Juani005999/ROMV2-SQMLite/README.md

# ROMV2 / SQM Lite

ROM V2 et SQM Lite

## Sommaire
- [Description](#description)
    - [Fonctionnalités](#fonctionnalités)
    - [Modèles](#modèles)
        - [Fonctionnalités par modèle](#fonctionnalités-par-modèle)
        - [Écrans disponibles](#écrans-disponibles)
    - [Echelle de Bortle](#echelle-de-bortle)
- [Liste des pièces](#liste-des-pièces)
    - [Liste des pièces du ROMV2](#liste-des-pièces-du-romv2)
        - [Amazon](#amazon)
        - [Ali Express](#ali-express)
        - [Visserie & Divers](#visserie--divers)
    - [Liste des pièces du SQMLite](#liste-des-pièces-du-sqmlite)
        - [Amazon](#amazon-1)
        - [Ali Express](#ali-express-1)
        - [Visserie & Divers](#visserie--divers-1)
- [Montage](#montage)
    - [Montage du ROMV2](#montage-du-romv2)
        - [Breadboard](#breadboard)
        - [PCB](#pcb)
        - [ESP32](#esp32)
        - [Capteurs](#capteurs)
    - [Montage du SQMLite](#montage-du-sqmlite)
        - [Breadboard](#breadboard-1)
        - [PCB](#pcb-1)
        - [ESP32](#esp32-1)
        - [Capteurs](#capteurs-1)
    - [Boxes](#boxes)
    - [Optique du TSL2591](#optique-du-tsl2591)
- [Firmware](#firmware)
    - [Bibliothèques nécessaires à l'application](#bibliothèques-nécessaires-à-lapplication)
    - [Sélection de la carte](#sélection-de-la-carte)
    - [Paramètres de l'application dans Arduino IDE](#paramètres-de-lapplication-dans-arduino-ide)
    - [Configuration de l'application](#configuration-de-lapplication)
    - [Configuration de l'écran TFT ST7735](#configuration-de-lécran-tft-st7735)
    - [Implémentation](#implémentation)
    - [Mode \"Debug\"](#mode-debug)
- [Utilisation](#utilisation)
    - [Matériel (ROMV2)](#matériel-romv2)
    - [Matériel (SQMLite)](#matériel-sqmlite)
    - [Navigation](#navigation)
    - [Mise en veille](#mise-en-veille)
    - [Logiciel](#logiciel)
        - [En-tête (ROMV2)](#en-tête-romv2)
        - [En-tête (SQMLite)](#en-tête-sqmlite)
        - [Ecran d'accueil](#ecran-daccueil)
        - [Ecran Luminosité](#ecran-luminosité)
        - [Ecran Environnement](#ecran-environnement)
        - [Ecran Ir Température](#ecran-ir-température)
        - [Ecran Niveaux](#ecran-niveaux)
        - [Ecran GPS](#ecran-gps)
        - [Ecran de calibration du capteur de luminosité TSL2591](#ecran-de-calibration-du-capteur-de-luminosité-tsl2591)
- [Driver ASCOM](#driver-ascom)
    - [Installation](#installation)
    - [Détection du périphérique bluetooth dans Windows](#détection-du-périphérique-bluetooth-dans-windows)
    - [Utilisation dans NINA](#utilisation-dans-nina)
        - [Sélection du ROM V2 dans NINA](#sélection-du-rom-v2-dans-nina)
        - [Première utilisation dans NINA](#première-utilisation-dans-nina)
- [Visualisation des données dans Grafana](#visualisation-des-données-dans-grafana)
    - [Mosquitto](#mosquitto)
    - [InfluxDB 2.x](#influxdb-2x)
    - [Telegraf](#telegraf)
    - [Grafana](#grafana)
    - [Résultat](#résultat)
- [Retex](#retex)
- [Révisions](#révisions)

## Description
Le **ROMV2** est un Sky Quality Meter (SQM) DIY (Do It Yourself) contenant les composants suivants :
- TSL2591
- MLX90614
- BME280
- ADXL345
- GPS NEO 8M
- TFT ST7735

Le **SQMLite** est un Sky Quality Meter (SQM) DIY (Do It Yourself) contenant les composants suivants :
- TSL2591
- BME280
- TFT ST7735

Le **SQMLite** est une version à moindre coût, centrée sur la mesure de qualité du ciel (SQM / Bortle) et des conditions d'environnement, sans la partie état du ciel, niveau à bulle ni GPS.

<p align="right"><a href="#sommaire">Retour au sommaire</a></p>

### Fonctionnalités

- Lecture de la luminosité (full / ir / visible), calcul de la quantité de lux, du SQM et du Bortle.
- Lecture de la luminosité dans une tâche dédiée FreeRTOS s'exécutant en parallèle sur le 2ème coeur de l'ESP 32.
- Correction thermique de la lecture de la luminosité avec la température ambiante.
- Moyenne mobile du lux sur 50 valeurs permettant de réduire l'incertitude mesurée. Calcul du SQM et du Bortle sur la moyenne mobile du lux.
- Possibilité de remise à zéro de la moyenne mobile.
- Réglage automatique de la sensibilité (1x, 25x, 428x, 9876x) et de la durée de mesure (100ms, 200ms, 300ms, 400ms, 500ms, 600ms) du capteur de luminosité TSL2591.
- (*) Lecture de la qualité du ciel (3 états : ciel clair / peu nuageux / nuageux) via le capteur MLX90614 permettant la lecture de la température du ciel.
- Lecture des conditions d'environnement (Température, taux d'humidité, pression atmosphérique) via le capteur BME280.
- Calcul du point de rosée.
- (*) Niveaux à bulle permettant de diriger l'optique vers le zénith grâce au capteur ADXL345.
- (*) Coordonnées GPS et Date/Heure UTC issues du capteur GPS NEO 8M.
- Connection Bluetooth BLE.
- Driver ASCOM permettant de se connecter via Bluetooth BLE.
- Connection Wifi et Broker MQTT.
- Indicateur de mesure de luminosité en cours.
- Indicateur d'état de connection Bluetooth BLE client / Wifi MQTT / Offline.
- (*) Indicateur d'état du GPS.
- Indicateur de charge restante dans la batterie.
- Mise en veille de l'écran après 5 minutes d'inactivité ou sur demande.
- Ecran de calibration du capteur de luminosité (TSL2591) avec sauvegarde et lecture de la calibration en EEPROM permettant de stocker cette valeur même après extinction de l'appareil.
- Ecran de sélection de la connection réseau : Bluetooth BLE / Wifi MQTT / Offline. Sauvegarde du paramètre en EEPROM.
- Ecran de paramétrage de la connection Wifi et Broker MQTT. Page web se connectant au périphérique et permettant la saisie des paramètres réseaux. Sauvegarde des paramètres réseaux en EEPROM.

(*) ***ROMV2*** uniquement

<p align="right"><a href="#sommaire">Retour au sommaire</a></p>

### Modèles

#### Fonctionnalités par modèle
| Composant / Fonction | ROMV2 | SQMLite |
| --- | :---: | :---: |
| TSL2591 — Luminosité / SQM / Bortle | ✅ | ✅ |
| BME280 — Environnement / point de rosée | ✅ | ✅ |
| TFT ST7735 — Affichage | ✅ | ✅ |
| MLX90614 — État du ciel (IR) | ✅ | ❌ |
| ADXL345 — Niveau à bulle | ✅ | ❌ |
| GPS NEO 8M — Coordonnées / UTC | ✅ | ❌ |
| Connexion BLE + Driver ASCOM | ✅ | ✅ |
| WiFi / MQTT | ✅ | ✅ |

#### Écrans disponibles
| Écran | ROMV2 | SQMLite |
| --- | :---: | :---: |
| Accueil | ✅ | ✅ |
| Luminosité | ✅ | ✅ |
| Environnement | ✅ | ✅ |
| Ir Température | ✅ | ❌ |
| Niveaux | ✅ | ❌ |
| GPS | ✅ | ❌ |
| Sélection de la connection réseau | ✅ | ✅ |
| Paramétrage du Wifi MQTT | ✅ | ✅ |
| Calibration du capteur de luminosité TSL 2591 | ✅ | ✅ |

> [!TIP]
> Le choix du modèle se fait simplement en ouvrant le bon exemple dans l'Arduino IDE (***Fichier*** -> ***Exemples*** -> ***ROMV2*** -> ***ROMV2*** ou ***SQMLite***). La même bibliothèque et la même configuration `ROMV2_APP_CONFIG.h` servent les deux.

<p align="right"><a href="#sommaire">Retour au sommaire</a></p>

### Echelle de Bortle

Voici l'échelle de Bortle utilisée dans l'application.

Bortle Scale

<p align="right"><a href="#sommaire">Retour au sommaire</a></p>

## Liste des pièces
### Liste des pièces du ROMV2
#### Amazon

| Composant | Prix | Nb. pièces | Prix unitaire |
| --- | --- | --- | --- |
| [ESP32 with Battery (Micro USB)](https://www.amazon.fr/dp/B07YXFBFWF) | 18.77 € | 1 | 18.77 € |
| [TSL2591](https://www.amazon.fr/dp/B0GGD3FNKM) | 15.10 € | 1 | 15.10 € |
| [BME280](https://www.amazon.fr/dp/B07HMQMW6M) | 30.99 € | 5 | 6.20 € |
| [ADXL345](https://www.amazon.fr/ADXL345-Acc%C3%A9l%C3%A9rom%C3%A8tres-Acc%C3%A9l%C3%A9rom%C3%A8tre-Num%C3%A9rique-Transmission/dp/B0CMHXKVFK) | 10.56 € | 5 | 2.12 € |
| [MLX90614](https://www.amazon.fr/Fyearfly-Capteur-Temp%C3%A9rature-Infrarouge-MLX90614ESF/dp/B0CG9VL65J) | 33.49 € | 2 | 16.75 € |
| [GPS NEO 8M](https://www.amazon.fr/ElectroWorldFR-Module-NEO-8M-antenne-c%C3%A9ramique/dp/B09TX372XH) | 20.99 € | 1 | 20.99 € |
| [TFT ST7735](https://www.amazon.fr/AZDelivery-TFT-Compatible-Raspberry-incluant/dp/B07TJGF8HS) | 27.99 € | 5 | 5.60 € |
| [Lentille D23 F30](https://www.amazon.fr/Lentille-biconvexe-Double-Convexe-Optique/dp/B0GVHDZD22) | 25.94 € | 1 | 25.94 € |
| [Joystick](https://www.amazon.fr/Gebildet-Joystick-Commande-Contr%C3%B4leur-Raspberry/dp/B0DPMN19G6) | 10.99 € | 8 | 1.37 € |
| [Boot Button](https://www.amazon.fr/dp/B07S1MNB8C) | 10.99 € | 5 | 2.20 € |
| [Interrupteur à bascule](https://www.amazon.fr/dp/B076VKRKQQ) | 6.49 € | 5 | 1.30 € |
| [Rallonge Micro USB](https://www.amazon.fr/dp/B08HCTZ9P5) | 11.79 € | 2 | 5.90 € |
| [Testeur de capacité](https://www.amazon.fr/dp/B0DKHT664R) | 13.19 € | 4 | 3.30 € |
| | | Total | **125.54 €** |

<p align="right"><a href="#sommaire">Retour au sommaire</a></p>

#### Ali Express
| Composant | Prix | Nb. pièces | Prix unitaire |
| --- | --- | --- | --- |
| [ESP32 with Battery (Micro USB)](https://fr.aliexpress.com/item/1005007579177706.html) | 4.19 € | 1 | 4.19 € |
| [TSL2591](https://fr.aliexpress.com/item/1005009222536594.html) | 4.19 € | 1 | 4.19 € |
| [BME280](https://fr.aliexpress.com/item/1005010256393146.html) | 2.99 € | 1 | 2.99 € |
| [ADXL345](https://fr.aliexpress.com/item/1005007076396937.html) | 2.04 € | 1 | 2.04 € |
| [MLX90614](https://fr.aliexpress.com/item/32853499710.html) | 5.93 € | 1 | 5.93 € |
| [GPS NEO 8M](https://fr.aliexpress.com/item/1005006323393609.html) | 9.29 € | 1 | 9.29 € |
| [TFT ST7735](https://fr.aliexpress.com/item/1005008974306385.html) | 3.20 € | 1 | 3.20 € |
| [Lentille D23 F30](https://fr.aliexpress.com/item/1005007033633969.html) | 2.06 € | 1 | 2.06 € |
| [Joystick](https://fr.aliexpress.com/item/1005009009852719.html) | 0.51 € | 1 | 0.51 € |
| [Boot Button](https://fr.aliexpress.com/item/1005007876916629.html) | 6.69 € | 5 | 1.34 € |
| [Interrupteur à bascule](https://fr.aliexpress.com/item/1005010311259797.html) | 1.65 € | 10 | 0.17 € |
| [Rallonge Micro USB](https://fr.aliexpress.com/item/1005005292730047.html) | 1.09 € | 1 | 1.09 € |
| [Testeur de capacité](https://fr.aliexpress.com/item/1005006350742151.html) | 1.45 € | 1 | 1.45 € |
| | | Total | **38.45 €** |

<p align="right"><a href="#sommaire">Retour au sommaire</a></p>

#### Visserie & Divers

| Composant | Propriétés | Quantité |
| --- | --- | --- |
| Vis & rondelles | M4 x 20mm | 8 |
| Vis & rondelles | M2 x 20mm | 4 |
| Vis & rondelles | M2 x 8mm | 21 |
| Vis & rondelles | M2 x 6mm | 8 |
| Ecrou Nylstop autobloquants | M2 | 7 |
| Condensateur | 100 µF | 1 |
| Condensateur céramique | 100 nF | 1 |
| [PCB EPLZON](https://www.amazon.fr/dp/B0B5DCHM7K) | ... | 1 |
| [Câbles Dupont](https://www.amazon.fr/Breadboard-Jumper-Wires-Dupont-Cable/dp/B0BTT48V7P) | ... | ... |
| [PCB Vis Connecteur](https://www.amazon.fr/dp/B082ZNRQMJ?th=1) | ... | ... |
| [Jumper Breadboard](https://www.amazon.fr/dp/B0F6LJS4L2?ref=ppx_yo2ov_dt_b_fed_asin_title) | ... | ... |
| [Pile Rechargeable 18650](https://bestpiles.fr/piles-rechargeables-18650/991-pile-rechargeable-18650-inr18650mj1-li-ion-37v-3500mah-10a-8438493099829.html) | Li-ion 3,7V 3500mAh 10A | 1 |

<p align="right"><a href="#sommaire">Retour au sommaire</a></p>

### Liste des pièces du SQMLite
#### Amazon

| Composant | Prix | Nb. pièces | Prix unitaire |
| --- | --- | --- | --- |
| ESP32 with Battery (USB-C) | 18.77 € | 1 | 18.77 € |
| [TSL2591](https://www.amazon.fr/dp/B0GGD3FNKM) | 12.69 € | 1 | 12.69 € |
| [BME280](https://www.amazon.fr/dp/B07HMQMW6M) | 39.48 € | 5 | 7.90 € |
| [TFT ST7735](https://www.amazon.fr/AZDelivery-TFT-Compatible-Raspberry-incluant/dp/B07TJGF8HS) | 27.99 € | 5 | 5.60 € |
| [Lentille D23 F30](https://www.amazon.fr/Lentille-biconvexe-Double-Convexe-Optique/dp/B0GVHDZD22) | 25.94 € | 1 | 25.94 € |
| [Joystick](https://www.amazon.fr/Gebildet-Joystick-Commande-Contr%C3%B4leur-Raspberry/dp/B0DPMN19G6) | 10.99 € | 8 | 1.37 € |
| [Boot Button](https://www.amazon.fr/dp/B07S1MNB8C) | 10.99 € | 5 | 2.20 € |
| [Interrupteur à bascule](https://www.amazon.fr/dp/B076VKRKQQ) | 7.49 € | 5 | 1.50 € |
| [Rallonge USB-C](https://www.amazon.fr/Cablecc-3-1-type-femelle-donn%C3%A9es-dextension/dp/B075P2FF7L) | 17.56 € | 1 | 17.56 € |
| [Testeur de capacité](https://www.amazon.fr/dp/B0DKHT664R) | 12.79 € | 4 | 3.20 € |
| | | Total | **96.73 €** |

<p align="right"><a href="#sommaire">Retour au sommaire</a></p>

#### Ali Express
| Composant | Prix | Nb. pièces | Prix unitaire |
| --- | --- | --- | --- |
| [ESP32 with Battery (USB-C)](https://fr.aliexpress.com/item/1005007579177706.html) | 5.09 € | 1 | 5.09 € |
| [TSL2591](https://fr.aliexpress.com/item/1005009222536594.html) | 3.79 € | 1 | 3.79 € |
| [BME280](https://fr.aliexpress.com/item/1005010256393146.html) | 4.59 € | 1 | 4.59 € |
| [TFT ST7735](https://fr.aliexpress.com/item/1005008974306385.html) | 3.29 € | 1 | 3.29 € |
| [Lentille D23 F30](https://fr.aliexpress.com/item/1005007033633969.html) | 2.33 € | 1 | 2.33 € |
| [Joystick](https://fr.aliexpress.com/item/1005009009852719.html) | 0.46 € | 1 | 0.46 € |
| [Boot Button](https://fr.aliexpress.com/item/1005007876916629.html) | 26.19 € | 20 | 1.31 € |
| [Interrupteur à bascule](https://fr.aliexpress.com/item/1005010311259797.html) | 1.79 € | 10 | 0.18 € |
| [Rallonge USB-C 0.2m](https://fr.aliexpress.com/item/1005005292730047.html) | 1.71 € | 1 | 1.71 € |
| [Testeur de capacité](https://fr.aliexpress.com/item/1005006350742151.html) | 1.45 € | 1 | 1.45 € |
| | | Total | **24.20 €** |

<p align="right"><a href="#sommaire">Retour au sommaire</a></p>

#### Visserie & Divers
| Composant | Propriétés | Quantité |
| --- | --- | --- |
| Vis & rondelles | M4 x 20mm | 8 |
| Vis & rondelles | M2 x 20mm | 4 |
| Vis & rondelles | M2 x 8mm | 21 |
| Vis & rondelles | M2 x 6mm | 8 |
| Ecrou Nylstop autobloquants | M2 | 7 |
| [PCB EPLZON](https://www.amazon.fr/dp/B0B5DCHM7K) | ... | 1 |
| [Câbles Dupont](https://www.amazon.fr/Breadboard-Jumper-Wires-Dupont-Cable/dp/B0BTT48V7P) | ... | ... |
| [PCB Vis Connecteur](https://www.amazon.fr/dp/B082ZNRQMJ?th=1) | ... | ... |
| [Jumper Breadboard](https://www.amazon.fr/dp/B0F6LJS4L2?ref=ppx_yo2ov_dt_b_fed_asin_title) | ... | ... |
| [Pile Rechargeable 18650](https://bestpiles.fr/piles-rechargeables-18650/991-pile-rechargeable-18650-inr18650mj1-li-ion-37v-3500mah-10a-8438493099829.html) | Li-ion 3,7V 3500mAh 10A | 1 |

<p align="right"><a href="#sommaire">Retour au sommaire</a></p>

## Montage

### Montage du ROMV2

Montage
Montage

<p align="right"><a href="#sommaire">Retour au sommaire</a></p>

#### Breadboard
Breadboard

<p align="right"><a href="#sommaire">Retour au sommaire</a></p>

#### PCB
PCB
PCB

<p align="right"><a href="#sommaire">Retour au sommaire</a></p>

#### ESP32
Des branchements direct sur l'ESP32 sont nécessaires :
- 2 câbles Dupont branchés directement sur l'interrupteur de l'ESP et connectés à l'interrupteur du ROM.
- 2 câbles branchés sur les pôles + et - de l'ESP et connectés à l'indicateur de charge restante de la batterie.

ESP32

> [!WARNING]
> Attention, le connecteur **micro USB** présent sur l'ESP est **très très fragile** (j'en ai personnellement cassé plusieurs sur d'autres projets en faisant des branchements). Je vous conseille donc de rajouter 2 points de soudure de part et d'autre du connecteur  afin d'augmenter sa solidité.

<p align="right"><a href="#sommaire">Retour au sommaire</a></p>

#### Capteurs
Capteurs
Capteurs

<p align="right"><a href="#sommaire">Retour au sommaire</a></p>

### Montage du SQMLite
Montage

<p align="right"><a href="#sommaire">Retour au sommaire</a></p>

#### Breadboard
Breadboard

<p align="right"><a href="#sommaire">Retour au sommaire</a></p>

#### PCB
PCB
PCB

<p align="right"><a href="#sommaire">Retour au sommaire</a></p>

#### ESP32
Des branchements direct sur l'ESP32 sont nécessaires :
- 2 câbles Dupont branchés directement sur l'interrupteur de l'ESP et connectés à l'interrupteur du **SQM Lite**.
- 2 câbles branchés sur les pôles + et - de l'ESP et connectés à l'indicateur de charge restante de la batterie.

ESP32

> [!WARNING]
> Attention, le connecteur **USB-C** présent sur l'ESP est **très très fragile** (j'en ai personnellement cassé plusieurs sur d'autres projets en faisant des branchements). Je vous conseille donc de rajouter 2 points de soudure de part et d'autre du connecteur  afin d'augmenter sa solidité.

<p align="right"><a href="#sommaire">Retour au sommaire</a></p>

#### Capteurs
Capteurs
Capteurs
Capteurs
Capteurs

<p align="right"><a href="#sommaire">Retour au sommaire</a></p>

### Boxes
Vous trouverez dans [ce dossier](./Boxes/) tous les fichiers STL nécessaires à l'impression 3D.

<p align="right"><a href="#sommaire">Retour au sommaire</a></p>

### Optique du TSL2591
TSL2591
TSL2591
TSL2591

> [!IMPORTANT]
> La partie encadrée en jaune correspond au côté des vis du TSL2591.

> [!TIP]
> La lentille est optionnelle. Vous pouvez uniquement positionner le cache du capteur et le tube sans la lentille. Vous pourrez ensuite corriger la [calibration](#ecran-de-calibration-du-capteur-de-luminosité-tsl2591) si nécessaire.

<p align="right"><a href="#sommaire">Retour au sommaire</a></p>

## Firmware

- Télécharger le fichier **ROMV2_Firmware.zip**
- Depuis votre Arduino IDE, installer la bibliothèque **ROMV2**, en sélectionnant le fichier téléchargé via le menu : \
***Croquis*** -> ***Importer une bibliothèque*** -> ***Ajouter la bibliothèque .ZIP ...***

ROMV2_LIB

<p align="right"><a href="#sommaire">Retour au sommaire</a></p>

### Bibliothèques nécessaires à l'application
Voici la liste des bibliothèques utilisées par l'application que vous devez installer via le gestionnaire de librairies dans votre *Arduino IDE* :

- Adafruit_TSL2591
- Adafruit_BME280
- Adafruit_MLX90614
- Adafruit_ADXL345
- TFT_eSPI
- PubSubClient

<p align="right"><a href="#sommaire">Retour au sommaire</a></p>

### Sélection de la carte
Dans votre *Arduino IDE*, sélectionnez la carte **ESP32 Dev Module**.
ESP32 Dev Module

<p align="right"><a href="#sommaire">Retour au sommaire</a></p>

### Paramètres de l'application dans Arduino IDE

> [!WARNING]
> Attention : l'application nécessite de se positionner en mode **"Huge App"** (cf. image ci-dessous), permettant ainsi de disposer de l'espace mémoire suffisant pour le fonctionnement sur l'ESP32.

Arduino IDE Huge App

<p align="right"><a href="#sommaire">Retour au sommaire</a></p>

### Configuration de l'application
Vous pouvez accéder à la configuration de l'application via le fichier suivant : \
\<***Arduino librairies***\> -> ***ROMV2*** -> ***src*** -> ***ROMV2_APP_CONFIG.h***

ROMV2_APP_CONFIG.h

<p align="right"><a href="#sommaire">Retour au sommaire</a></p>

### Configuration de l'écran TFT ST7735
Afin de faire fonctionner votre écran, il vous sera nécessaire de le configurer via la bibliothèque **TFT_eSPI** en modifiant le fichier suivant : \
\<***Arduino librairies***\> -> ***TFT_eSPI*** -> ***User_Setup.h***

Vous devez modifier 2 paramètres :

- La sélection de votre écran :
TFT_eSPI Select Screen
- Les PINs associés à votre écran :
TFT_eSPI Select PINs

<p align="right"><a href="#sommaire">Retour au sommaire</a></p>

### Implémentation
Pour démarrer un nouveau projet **ROMV2**, il vous suffit d'aller dans les exemples de votre Arduino IDE, et de sélectionner ***ROMV2*** -> ***ROMV2***.

ROMV2 Application example

Pour démarrer un nouveau projet **SQMLite**, il vous suffit d'aller dans les exemples de votre Arduino IDE, et de sélectionner ***ROMV2*** -> ***SQMLite***.

SQMLite Application example

<p align="right"><a href="#sommaire">Retour au sommaire</a></p>

### Mode \"Debug\"
Pendant le développement de votre projet, vous pouvez activer le mode **Debug**.

> [!WARNING]
> Afin d'améliorer les performances, **n'oubliez pas de le désactiver une fois le projet abouti**.

Dans le fichier suivant : \
\<***Arduino librairies***\> -> ***ROMV2*** -> ***src*** -> ***JUANITO_APP.h*** \
Enlevez les commentaires devant la ligne : \
`#define DEBUG`

ROMV2 Debug

En activant le mode **Debug**, vous pourrez voir les traces de l'application dans le *Moniteur série* de votre *Arduino IDE* pendant l'exécution. 

ROMV2 Logs

<p align="right"><a href="#sommaire">Retour au sommaire</a></p>

## Utilisation

### Matériel (ROMV2)
ROMV2 Logs

Vous trouverez au bas du ***ROMV2*** :
- l'interrupteur On/Off de l'appareil.
- 1 connecteur **Micro USB** permettant de recharger le ***ROMV2*** et servant également à la mise à jour du firmware.
- 1 interrupteur (bouton poussoir) permettant de mettre l'ESP en mode Boot lors de la mise à jour du firmware.
- L'indicateur de charge restante dans la batterie. Appuyez sur le bouton **"TEST"** de l'indicateur pour connaître la charge restante.

<p align="right"><a href="#sommaire">Retour au sommaire</a></p>

### Matériel (SQMLite)
SQMLite Bottom
SQMLite Right

Vous trouverez au bas du ***SQMLite*** :
- 1 connecteur **USB-C** permettant de recharger le ***SQMLite*** et servant également à la mise à jour du firmware.
- 1 interrupteur (bouton poussoir) permettant de mettre l'ESP en mode Boot lors de la mise à jour du firmware.

Vous trouverez sur le côté droit du ***SQMLite*** :
- l'interrupteur On/Off de l'appareil.
- L'indicateur de charge restante dans la batterie. Appuyez sur le bouton **"TEST"** de l'indicateur pour connaître la charge restante.

<p align="right"><a href="#sommaire">Retour au sommaire</a></p>

### Navigation

Le pilotage du ***ROMV2*** et du ***SQMLite*** s'effectue via le joystick :
- Droite et gauche permettent de naviguer parmi les différents écrans.
- Haut et Bas permettent un retour direct à l'écran d'accueil.
- Sur l'écran d'accueil, un clic sur le joystick permet d'alterner l'affichage Lux et SQM.
- Sur l'écran de luminosité, un clic sur le joystick permet de réinitialiser la moyenne mobile en cours.
- Un clic long sur le joystick permet de basculer l'écran en mode veille.
- Sur l'écran de sélection du réseau, Haut et Bas permettent de modifier le nouveau réseau sélectionné, et un clic sur le joystick permet de sauvegarder la nouvelle valeur du paramètre.
- Sur l'écran de paramétrage du réseau Wifi, un clic sur le joystick permet de passer l'ESP en mode AP (Access Point) ou STA (Station) et inversement. 
- Sur l'écran de calibration du TSL2591, Haut et Bas permettent de modifier la nouvelle valeur de calibration, et un clic sur le joystick permet de sauvegarder la nouvelle valeur du paramètre.

### Mise en veille

L'écran du ***ROMV2*** / ***SQMLite*** s'éteint automatiquement après 5 min d'inactivité (modifiable dans le fichier de configuration).
Cette mise en veille peut être déclenchée à tout moment par un "click long" sur le joystick.

Pour sortir du mode veille, il suffit d'effectuer une action sur le joystick, peu importe laquelle.

<p align="right"><a href="#sommaire">Retour au sommaire</a></p>

### Logiciel

Le firmware est constitué de plusieurs écrans, avec un en-tête commun à tous les écrans.

#### En-tête (ROMV2)

Header

L'en-tête comprend les éléments suivants :
- Un icone principal spécifique à l'écran en cours d'affichage.
- La date et l'heure UTC remontée par le capteur GPS.
- Un icone indiquant qu'une prise de mesure de la luminosité est en cours.
- Un icone d'état de la connexion en cours. Trois types d'icone selon la connexion :
    - Icone ***Offline***.
    - Icone ***Bluetooth***. Deux états pour cet icone :
        - Rouge : Aucun client Bluetooth BLE connecté.
        - Vert : Un client BLE est actuellement connecté.
    - Icone ***Wifi***. Quatre états pour cet icone :
        - Rouge : Wifi non connecté.
        - Orange : Connexion en cours OU ESP en mode AP (Access Point).
        - Bleu : Wifi connecté en mode STA (Station) mais aucune connexion avec un Broker MQTT (exple : Mosquito).
        - Vert : Wifi connecté en mode STA (Station) et connexion avec un Broker MQTT effectuée.
- Un icone indiquant si le GPS est "fixé", remontant ainsi les informations de localisation (2 états : rouge et vert). Est également précisé le nombre de satellites à partir desquels le capteur récupère les informations. 

<p align="right"><a href="#sommaire">Retour au sommaire</a></p>

#### En-tête (SQMLite)

Header

L'en-tête comprend les éléments suivants :
- Un icone principal spécifique à l'écran en cours d'affichage.
- Le titre de l'application.
- Un icone indiquant qu'une prise de mesure de la luminosité est en cours.
- Un icone d'état de la connexion en cours. Trois types d'icone selon la connexion :
    - Icone ***Offline***.
    - Icone ***Bluetooth***. Deux états pour cet icone :
        - Rouge : Aucun client Bluetooth BLE connecté.
        - Vert : Un client BLE est actuellement connecté.
    - Icone ***Wifi***. Quatre états pour cet icone :
        - Rouge : Wifi non connecté.
        - Orange : Connexion en cours OU ESP en mode AP (Access Point).
        - Bleu : Wifi connecté en mode STA (Station) mais aucune connexion avec un Broker MQTT (exple : Mosquito).
        - Vert : Wifi connecté en mode STA (Station) et connexion avec un Broker MQTT effectuée.

<p align="right"><a href="#sommaire">Retour au sommaire</a></p>

#### Ecran d'accueil

L'écran d'accueil comprend les éléments suivants :
- L'affichage des coordonnées GPS.
- Un icone représentant l'état du ciel. L'icone a trois états : 
    - Ciel clair.
    - Peu nuageux.
    - Nuageux.
- Un icone représentant le point de rosée ainsi que la température du point de rosée. L'icone a trois états :
    - Bleu : pas de risque de buée.
    - Orange : point de rosée à moins de 5°c de la température ambiante, risque de buée imminente.
    - Rouge : point de rosée atteint, pare-buée obligatoire.
- Un icone affichant la valeur de Bortle en cours.
- Un espace affichant la valeur de luminosité mesurée. 2 modes d'affichage :
    - Affichage du Lux
    - Affichage du SQM (Mag / Arcsec²).\
> [!TIP]
> On passe d'un mode à l'autre (Lux / SQM) en cliquant sur le joystick.
- Un espace affichant la valeur de la température ambiante.

Screen Home Lux

Screen Home SQM

<p align="right"><a href="#sommaire">Retour au sommaire</a></p>

#### Ecran Luminosité

Screen Lux

L'écran Luminosité comprend les éléments suivants :
- La luminosité mesurée totale et dans les Infrarouge.
- La luminosité mesurée dans le visible.
- La quantité de Lux issue des mesures Ir et Full.
- La quantité de Lux sur une moyenne mobile. Le nombre de mesures permettant de calculer la moyenne est entre parenthèse. Le nombre maximum de valeurs pour le calcul de la moyenne mobile est de 50 (ce nombre est modifiable dans le fichier de configuration via la constante `TSL2591_MOVING_AVERAGE_COUNT`).
- Le SQM (Mag / Arcsec²) calculé à partir du Lux moyen.
- Le Bortle issu de la valeur du SQM calculé.
- Le gain du capteur lors de la dernière mesure de luminosité effectuée.
- Le temps d'exposition du capteur lors de la dernière mesure de luminosité effectuée.

> [!NOTE]
> Le gain et le temps d'exposition du capteur sont ajustés automatiquement par le firmware afin d'avoir les valeurs les plus appropriées en fonction du contexte.

> [!IMPORTANT]
> Pour réinitialiser la moyenne mobile effectuée sur la mesure de Lux, il suffit d'effectuer un **clic sur le joystick**.

<p align="right"><a href="#sommaire">Retour au sommaire</a></p>

#### Ecran Environnement

Screen Lux

L'écran Environnement comprend les éléments suivants :
- La température ambiante (°C).
- Le taux d'humidité (%).
- La pression atmosphérique (Pa).
- Un icone représentant le point de rosée ainsi que la température du point de rosée. L'icone a trois états :
    - Bleu : pas de risque de buée.
    - Orange : point de rosée à moins de 5°c de la température ambiante, risque de buée imminente.
    - Rouge : point de rosée atteint, pare-buée obligatoire.

<p align="right"><a href="#sommaire">Retour au sommaire</a></p>

#### Ecran Ir Température

Screen Lux

L'écran Ir Température permet d'afficher l'état du ciel. Il comprend les éléments suivants :
- Un icone représentant l'état du ciel. L'icone a trois états : 
    - Ciel clair.\
    Sky State Clear
    - Peu nuageux.\
    Sky State Partly Cloudy
    - Nuageux.\
    Sky State Cloudy
- La température ambiante mesurée.
- La température de l'objet mesurée.

<p align="right"><a href="#sommaire">Retour au sommaire</a></p>

#### Ecran Niveaux

Screen Lux

L'écran Niveaux permet d'afficher un niveau à bulle afin de positionner correctement le capteur de luminosité au zénith. Il comprend les éléments suivants :
- Un niveau à bulle de forme circulaire.
- L'accélération en X (m / s²).
- L'accélération en Y (m / s²).
- L'accélération en Z (m / s²).

<p align="right"><a href="#sommaire">Retour au sommaire</a></p>

#### Ecran GPS

Screen Lux

L'écran GPS permet d'afficher les données issues du GPS. Il comprend les éléments suivants :
- Les coordonnées longitude et latitude en degrés, minutes, secondes et dizaines de secondes, orientation.
- Le nombre de satellites à partir desquels le capteur GPS récupère les informations.
- L'état "fixé" ou non.
- L'altitude courante (m).

<p align="right"><a href="#sommaire">Retour au sommaire</a></p>

#### Ecran de calibration du capteur de luminosité TSL2591

Screen Calibration TSL2591

L'écran de calibration du capteur de luminosité TSL2591 permet de définir la calibration qui sera utilisée lors du calcul du SQM (et du Bortle). Il comprend les éléments suivants :
- La valeur actuelle.
- La nouvelle valeur à enregistrer en EEPROM.

> [!NOTE]
> Vous pouvez modifier cette valeur grâce au joystick :
>- Un mouvement court vers le haut incrémente la valeur de 0.01.
>- Un mouvement long vers le haut augmente rapidement la valeur.
>- Un mouvement court vers le bas décrémente la valeur de 0.01.
>- Un mouvement long vers le bas diminue rapidement la valeur.
>- Un clic sur le joystick permet l'enregistrement de cette nouvelle valeur en EEPROM.

<p align="right"><a href="#sommaire">Retour au sommaire</a></p>

## Driver ASCOM

Driver Setup Dialog

### Installation

- Téléchargez et exécutez le fichier correspondant à votre modèle :
    - ***ROMV2*** : **ASCOM driver for ROMV2 Setup.exe**
    - ***SQMLite*** : **ASCOM driver for SQMLite Setup.exe**

Driver Installer screen 1

Driver Installer screen 2

Driver Installer screen 3

<p align="right"><a href="#sommaire">Retour au sommaire</a></p>

### Détection du périphérique bluetooth dans Windows

Afin de pouvoir utiliser le Driver ASCOM ROM V2 - SQM ou SQMLite depuis votre application Astro comme N.I.N.A., vous devez au préalable déclarer votre périphérique Bluetooth auprès de votre système Windows.

> [!IMPORTANT]
> Cette opération de reconnaissance de votre périphérique Bluetooth auprès de votre système Windows n'est à faire qu'une seule fois, lors de la première utilisation.

Windows bluetooth

Dans la fenêtre des paramètres windows, allez dans la section "***Bluetooth et appareils***", si nécessaire, cliquez sur "***Afficher d'autres périphériques***", puis cliquez sur le bouton "***Ajouter un appareil***" et suivez les étapes de l'assistant.

<p align="right"><a href="#sommaire">Retour au sommaire</a></p>

### Utilisation dans NINA

NINA

#### Sélection du ROM V2 dans NINA

Afin de sélectionner le ROM V2 - SQM ou le SQMLite dans N.I.N.A., allez dans l'onglet "***Equipements***", et dans le sous-onglet "***Météo***".\
Dans la liste déroulante, sélectionnez :
- ***ROMV2*** : "***ROM V2 - Sky Quality Meter***"
- ***SQMLite*** : "***SQMLite - Sky Quality Meter***"

NINA Sélection ROM

<p align="right"><a href="#sommaire">Retour au sommaire</a></p>

#### Première utilisation dans NINA

Lors de la première utilisation dans N.I.N.A., un appairage du ROM V2 - SQM ou du SQMLite est nécessaire.\
Pour cela, cliquez sur le bouton "***Paramètres***".

NINA ROM settings

Dans la boîte de dialogue qui s'ouvre, sélectionnez le périphérique détecté puis validez :
- ***ROMV2*** : "***REMOTE OPEN METEO***"
- ***SQMLite*** : "***SQM Lite***"

Driver Setup Dialog

> [!NOTE]
> Voilà, l'appairage est effectué. Il ne sera plus nécessaire d'effectuer cette opération lors des prochaines utilisations.

<p align="right"><a href="#sommaire">Retour au sommaire</a></p>

Voilà, vous pouvez désormais profiter des données du ROM V2 - SQM ou du SQMLite dans NINA.\
Enjoy

NINA démo

<p align="right"><b><i>Juanito del Pepito</i></b></p>

## Visualisation des données dans Grafana

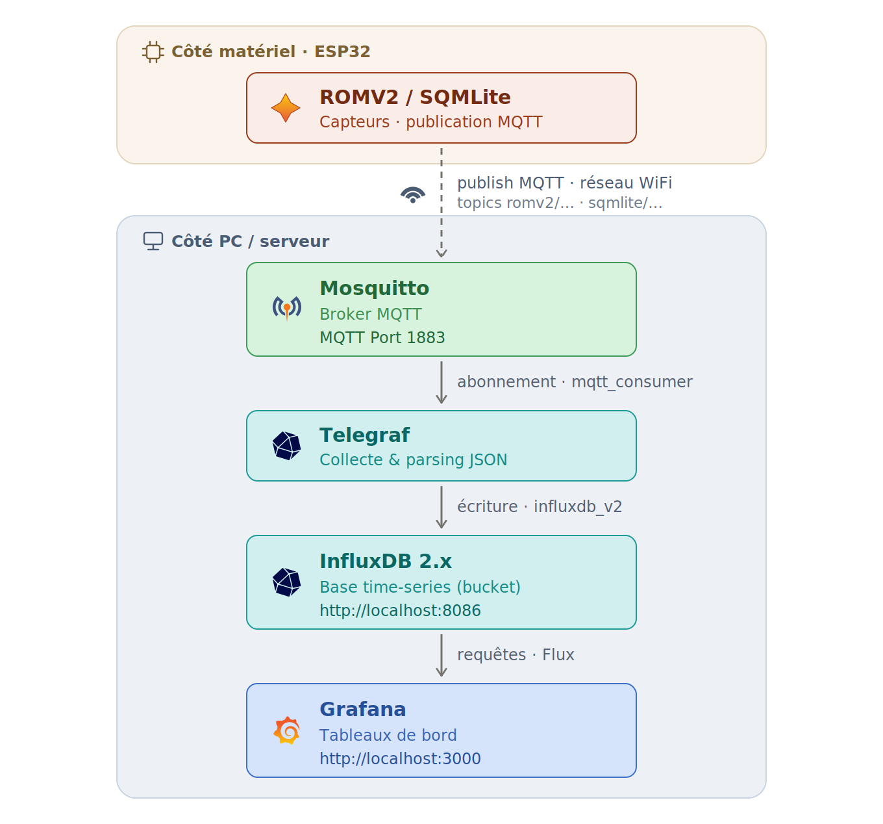
[picture p1: screenshots/MQTT_Pipeline.png]
MQTT Pipeline


Lorsque la connexion réseau ***Wifi MQTT*** est sélectionnée, le ***ROMV2*** / ***SQMLite*** publie ses mesures toutes les 10 secondes auprès d'un Broker MQTT. Ces mesures peuvent ensuite être historisées et affichées sous forme de tableaux de bord grâce à la chaîne suivante :
- **Mosquitto** : Broker MQTT recevant les mesures publiées par l'appareil.
- **Telegraf** : abonné aux topics MQTT, il collecte les mesures et les écrit dans InfluxDB.
- **InfluxDB 2.x** : base de données time-series stockant l'historique des mesures.
- **Grafana** : affichage des mesures sous forme de tableaux de bord.

Les topics publiés sont les suivants (une valeur brute par topic) :

| Topic | ROMV2 | SQMLite |
| --- | :---: | :---: |
| `<modèle>/environment/temperature` · `humidity` · `pressure` · `dewpoint` | ✅ | ✅ |
| `<modèle>/luminosity/lux` · `sqm` · `bortle` | ✅ | ✅ |
| `romv2/sky/temp_ambient` · `temp_object` · `cloud_cover` | ✅ | ❌ |
| `romv2/sky/state` (texte : `CLEAR` / `PARTLY_CLOUDY` / `CLOUDY`) | ✅ | ❌ |
| `romv2/acceleration/x` · `y` · `z` | ✅ | ❌ |
| `romv2/gps/latitude` · `longitude` · `altitude` · `satellites` (texte) | ✅ | ❌ |
| `romv2/gps/fix` (`0` / `1`) | ✅ | ❌ |

`<modèle>` vaut `romv2` ou `sqmlite`.

> [!NOTE]
> Les 4 logiciels peuvent être installés sur le même PC (cas décrit ci-dessous, sous Windows) ou sur un serveur (Raspberry Pi, NAS, ...). Le PC hébergeant Mosquitto doit être joignable par l'appareil sur le réseau Wifi.

<p align="right"><a href="#sommaire">Retour au sommaire</a></p>

### Mosquitto

- Téléchargez et installez **Mosquitto** depuis le site officiel : [mosquitto.org/download](https://mosquitto.org/download/). Mosquitto est installé en tant que service Windows (***Mosquitto Broker***).
- Par défaut, Mosquitto n'accepte que les connexions locales. Afin d'autoriser l'appareil à se connecter, modifiez le fichier `C:\Program Files\Mosquitto\mosquitto.conf` en y ajoutant les lignes suivantes :

```
listener 1883
allow_anonymous true
```

- Autorisez le port **1883** (TCP entrant) dans le pare-feu Windows.
- Redémarrez le service ***Mosquitto Broker*** (via ***services.msc***, ou en ligne de commande en tant qu'administrateur : `net stop mosquitto` puis `net start mosquitto`).
- Sur l'appareil, renseignez l'adresse IP du PC et le port **1883** dans l'écran de paramétrage du Wifi MQTT. L'icone Wifi de l'en-tête passe au **vert** une fois la connexion au Broker établie.

> [!TIP]
> Vous pouvez vérifier la réception des mesures avec la commande suivante (depuis le répertoire d'installation de Mosquitto) : \
> `mosquitto_sub -h localhost -t "sqmlite/#" -v` (ou `"romv2/#"`)

> [!WARNING]
> `allow_anonymous true` autorise n'importe quel client du réseau local à se connecter au Broker. Réservez cette configuration à un réseau domestique de confiance.

<p align="right"><a href="#sommaire">Retour au sommaire</a></p>

### InfluxDB 2.x

- Téléchargez **InfluxDB 2.x** (OSS) pour Windows depuis le site officiel : [docs.influxdata.com/influxdb/v2/install](https://docs.influxdata.com/influxdb/v2/install/).
- Décompressez l'archive dans un répertoire (ex : `C:\InfluxDB`), puis lancez `influxd.exe`.
- Ouvrez l'interface web [http://localhost:8086](http://localhost:8086) et suivez l'assistant de configuration initiale :
    - Création de l'utilisateur administrateur.
    - Nom de l'organisation (ex : `Perso`).
    - Nom du bucket (ex : `ROMV2`).
- Dans ***Load Data*** -> ***API Tokens***, générez un token qui sera utilisé par Telegraf (écriture dans le bucket) et par Grafana (lecture du bucket).

> [!IMPORTANT]
> Conservez précieusement ce token : il n'est affiché qu'une seule fois lors de sa création.

<p align="right"><a href="#sommaire">Retour au sommaire</a></p>

### Telegraf

- Téléchargez **Telegraf** pour Windows depuis le site officiel : [docs.influxdata.com/telegraf/v1/install](https://docs.influxdata.com/telegraf/v1/install/).
- Décompressez l'archive dans un répertoire (ex : `C:\InfluxData\telegraf`).
- Remplacez le contenu du fichier `telegraf.conf` par la configuration suivante, en adaptant l'organisation, le bucket et le token InfluxDB :

```toml
[agent]
  interval = "10s"
  flush_interval = "10s"
  omit_hostname = false

# Ecriture dans InfluxDB 2.x
[[outputs.influxdb_v2]]
  urls = ["http://localhost:8086"]
  token = "VOTRE_TOKEN_INFLUXDB"
  organization = "Perso"
  bucket = "ROMV2"

# Mesures numériques ROMV2 / SQMLite
[[inputs.mqtt_consumer]]
  servers = ["tcp://127.0.0.1:1883"]
  topics = [
    "sqmlite/#",
    "romv2/environment/#",
    "romv2/luminosity/#",
    "romv2/sky/temp_ambient",
    "romv2/sky/temp_object",
    "romv2/sky/cloud_cover",
    "romv2/acceleration/#",
    "romv2/gps/fix"
  ]
  data_format = "value"
  data_type = "float"

# Mesures texte ROMV2 (état du ciel, GPS)
[[inputs.mqtt_consumer]]
  servers = ["tcp://127.0.0.1:1883"]
  topics = [
    "romv2/sky/state",
    "romv2/gps/latitude",
    "romv2/gps/longitude",
    "romv2/gps/altitude",
    "romv2/gps/satellites"
  ]
  data_format = "value"
  data_type = "string"
  name_override = "mqtt_consumer_text"
```

> [!NOTE]
> Les mesures texte sont écrites dans une measurement distincte (`mqtt_consumer_text`) afin d'éviter un conflit de type avec les mesures numériques dans InfluxDB.

- Lancez Telegraf depuis le répertoire d'installation : \
`telegraf.exe --config telegraf.conf`
- Ou installez-le en tant que service Windows (en tant qu'administrateur) : \
`telegraf.exe --service install --config "C:\InfluxData\telegraf\telegraf.conf"` puis `net start telegraf`

Chaque mesure est stockée dans InfluxDB avec le champ `value` et les tags `topic` et `host`.

<p align="right"><a href="#sommaire">Retour au sommaire</a></p>

### Grafana

- Téléchargez et installez **Grafana** (OSS) pour Windows depuis le site officiel : [grafana.com/grafana/download](https://grafana.com/grafana/download?platform=windows). Grafana est installé en tant que service Windows.
- Ouvrez l'interface web [http://localhost:3000](http://localhost:3000) (identifiant / mot de passe par défaut : `admin` / `admin`, un nouveau mot de passe vous est demandé à la première connexion).
- Dans ***Connections*** -> ***Data sources***, ajoutez une source de données **InfluxDB** :
    - Query language : **Flux**.
    - URL : `http://localhost:8086`.
    - Organization : `Perso`.
    - Token : le token généré dans InfluxDB.
    - Default Bucket : `ROMV2`.
- Créez un nouveau tableau de bord (***Dashboards*** -> ***New dashboard***), puis ajoutez un panneau par mesure à afficher. Exemple de requête Flux pour afficher le SQM du SQMLite :

```
from(bucket: "ROMV2")
  |> range(start: v.timeRangeStart, stop: v.timeRangeStop)
  |> filter(fn: (r) => r._measurement == "mqtt_consumer")
  |> filter(fn: (r) => r.topic == "sqmlite/luminosity/sqm")
  |> filter(fn: (r) => r._field == "value")
  |> aggregateWindow(every: v.windowPeriod, fn: mean, createEmpty: false)
```

Il suffit de remplacer le topic pour afficher les autres mesures (`sqmlite/luminosity/bortle`, `sqmlite/luminosity/lux`, `sqmlite/environment/temperature`, ...).

> [!TIP]
> Les panneaux ***Lune*** et ***Soleil*** du tableau de bord ci-dessous utilisent le plugin Grafana **Sun and Moon** ([grafana.com/grafana/plugins/fetzerch-sunandmoon-datasource](https://grafana.com/grafana/plugins/fetzerch-sunandmoon-datasource/)), qui calcule la hauteur du soleil, de la lune et l'illumination de la lune à partir de vos coordonnées. Très pratique pour mettre en relation les mesures de SQM avec le crépuscule et la présence de la lune.

<p align="right"><a href="#sommaire">Retour au sommaire</a></p>

### Résultat

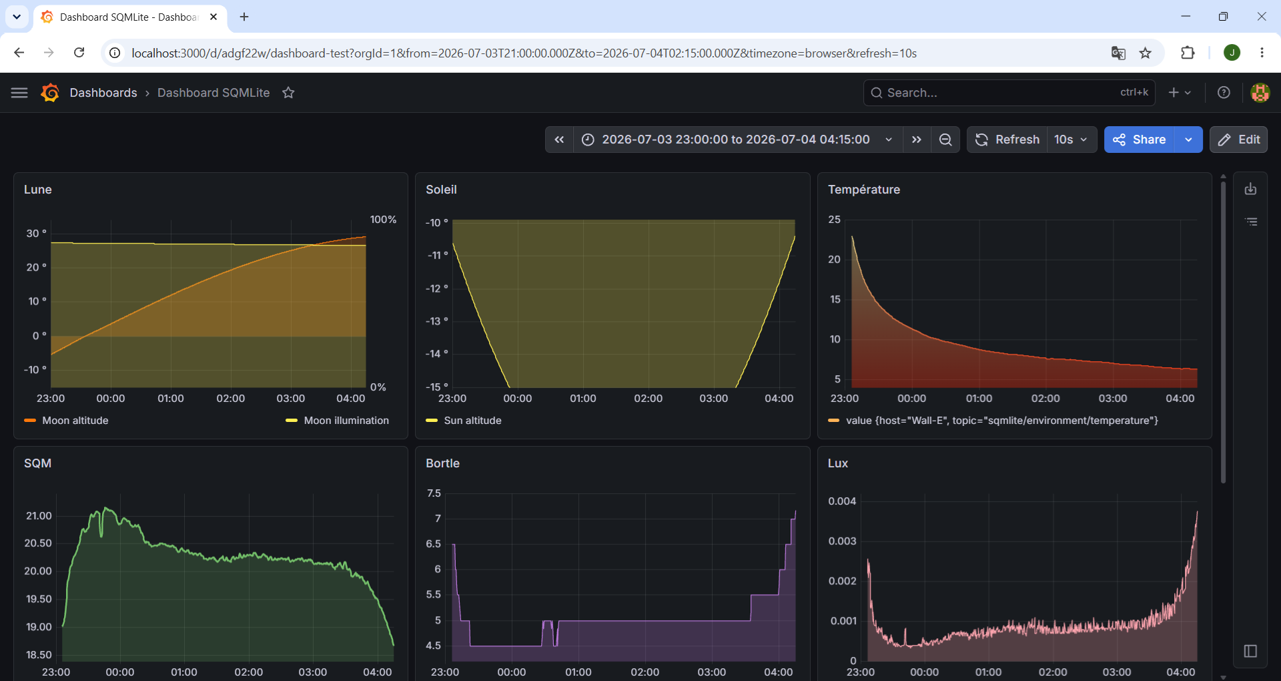
[picture p2: screenshots/Grafana_Dashboard.png]
Grafana Dashboard


<p align="right"><a href="#sommaire">Retour au sommaire</a></p>

## Retex

Voici un petit retour d'expérience des mesures de l'état de mon ciel à mon domicile :

NINA démo

## Révisions

| Date | Version | Commentaires |
| --- | --- | --- |
| 30/06/2026 | 2.1.0.1 | <ul><li>Fusion ROMV2 / SQMLite : une seule bibliothèque et une seule configuration pour les deux modèles, choix du modèle via l'exemple ROMV2 ou SQMLite.</li><li>Connexion Wifi (tâche dédiée FreeRTOS) et Broker MQTT, avec des Topics MQTT distincts pour le ROMV2 et le SQMLite.</li><li>Nouvel écran de sélection de la connexion réseau (Bluetooth BLE / Wifi MQTT / Offline) avec sauvegarde en EEPROM.</li><li>Nouvel écran de paramétrage du Wifi et du Broker MQTT via une page web (ESP en mode AP), avec sauvegarde en EEPROM.</li><li>Accès au bus I2C protégé par mutex.</li><li>Démarrage non bloquant de l'advertising Bluetooth BLE.</li></ul> |
| 27/05/2026 | 2.0.3.1 | <ul><li>Ajout d'un nouvel écran permettant la calibration du capteur de luminosité TSL2591.</li><li>Sauvegarde et lecture de la calibration en EEPROM permettant de stocker cette valeur même après extinction de l'appareil.</ul> |
| 23/05/2026 | 2.0.2.1 | Correction thermique de la lecture de la luminosité avec la température ambiante. |
| 17/05/2026 | 2.0.1.2 | Simplification du train optique du TSL2591. |
| 08/05/2026 | 2.0.1.1 | Lecture de la luminosité dans une tâche dédiée FreeRTOS s'exécutant en parallèle sur le 2ème coeur de l'ESP 32. |
| 30/04/2026 | 2.0.0.1 | Version initiale. |

<p align="right"><a href="#sommaire">Retour au sommaire</a></p>
