Juani005999/ROMV2-SQMLite/screenshots/Projet_Low.jpg

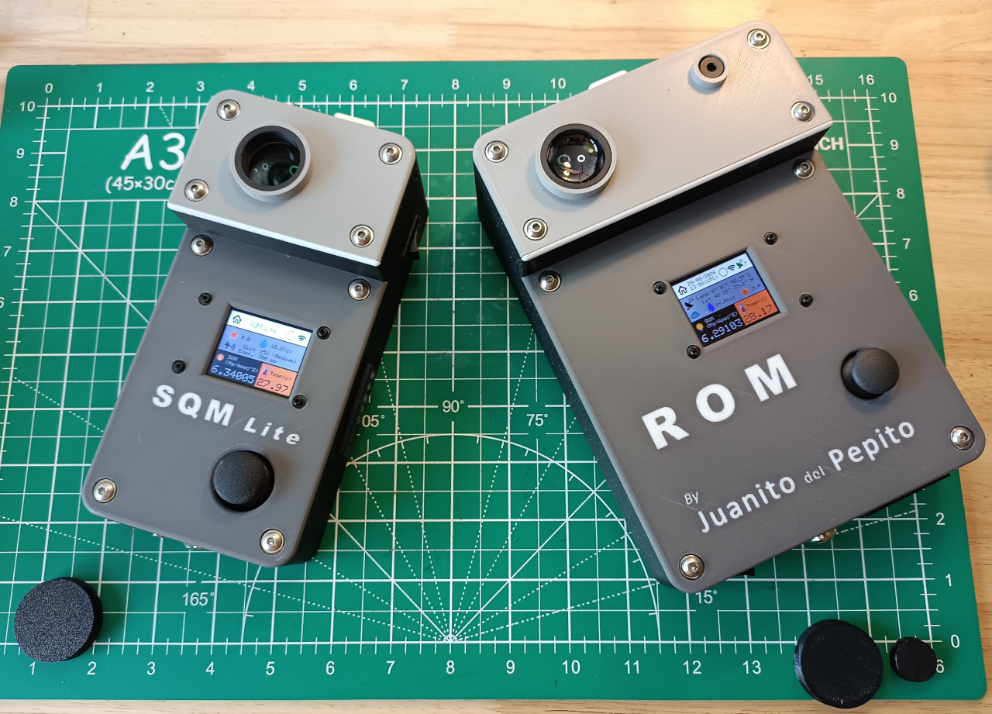
screenshots/Projet_Low.jpg
