Juani005999/ROMV2-SQMLite/Boxes/ROMV2_Sensor.stl

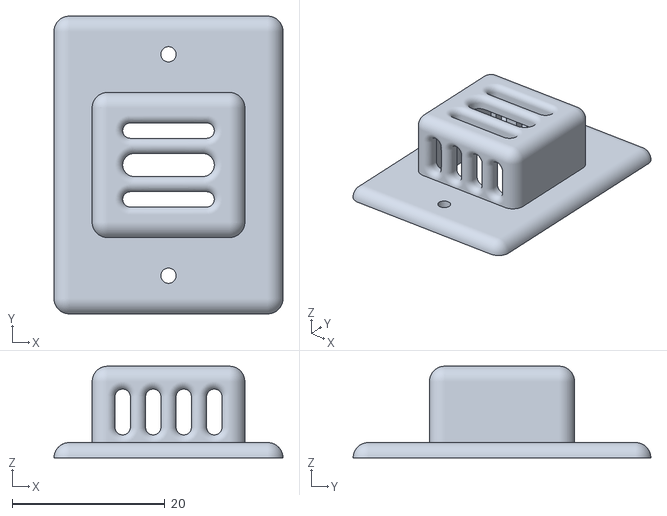
[picture p4: CAD file, 2026-10-11]
Boxes/ROMV2_Sensor.stl
30.0 x 39.0 x 12.0
