Juani005999/ROMV2-SQMLite/Boxes/SQMLITE_TopHigh.stl

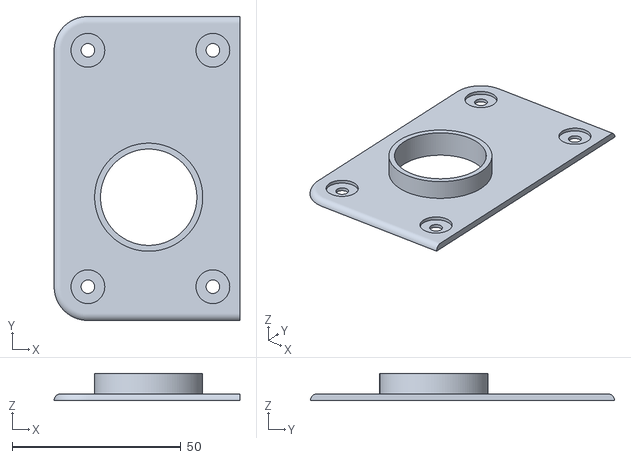
[picture p5: CAD file, 2026-10-11]
Boxes/SQMLITE_TopHigh.stl
55.0 x 90.0 x 8.00
