Juani005999/ROMV2-SQMLite/Boxes/ROMV2_Bottom.stl

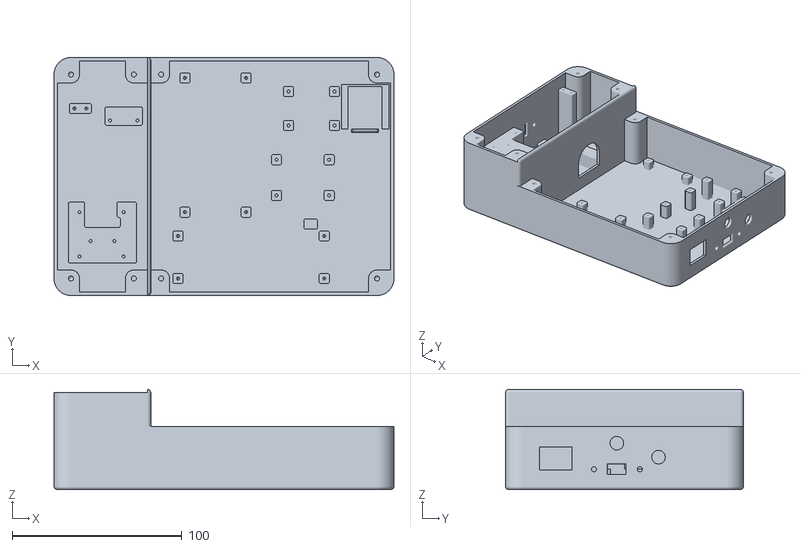
[picture p6: CAD file, 2026-10-11]
Boxes/ROMV2_Bottom.stl
200.0 x 140.0 x 59.0
