Juani005999/ROMV2-SQMLite/Boxes/SQMLITE_TopLow.stl

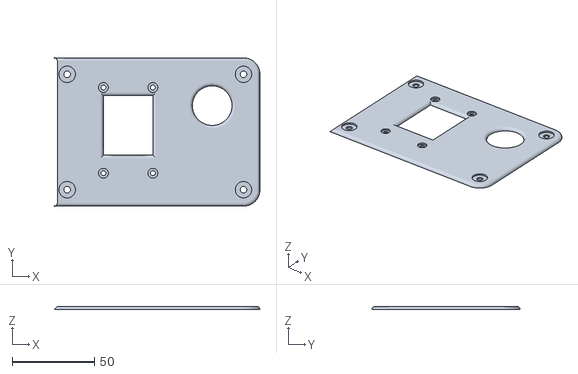
[picture p7: CAD file, 2026-10-11]
Boxes/SQMLITE_TopLow.stl
125.0 x 90.0 x 2.00
