Juani005999/ROMV2-SQMLite/Boxes/SQMLITE_Bottom_USB-C.stl

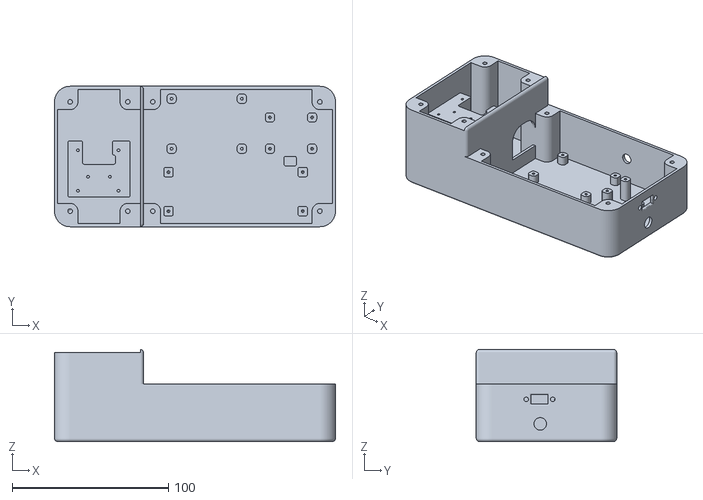
[picture p8: CAD file, 2026-10-11]
Boxes/SQMLITE_Bottom_USB-C.stl
180.0 x 90.0 x 59.0
