Juani005999/ROMV2-SQMLite/Boxes/Tube15_Cover_TPU.stl

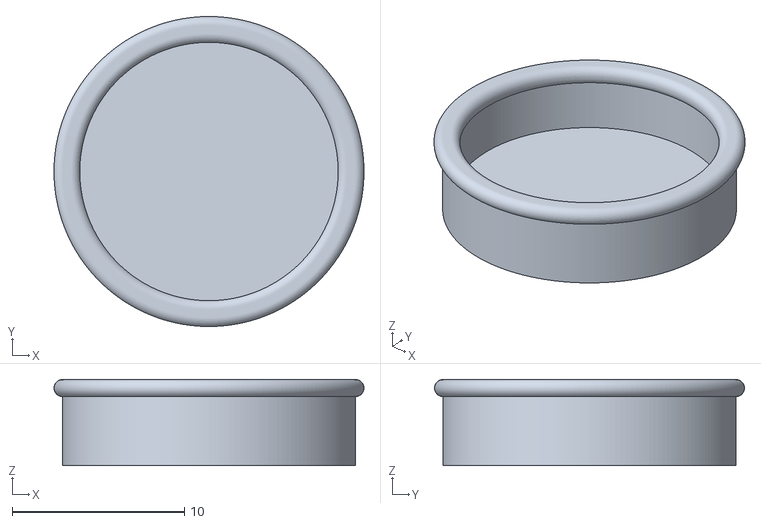
[picture p9: CAD file, 2026-10-11]
Boxes/Tube15_Cover_TPU.stl
18.0 x 18.0 x 5.00
