Juani005999/ROMV2-SQMLite/Boxes/TSL2591_Enclosure_H11.stl

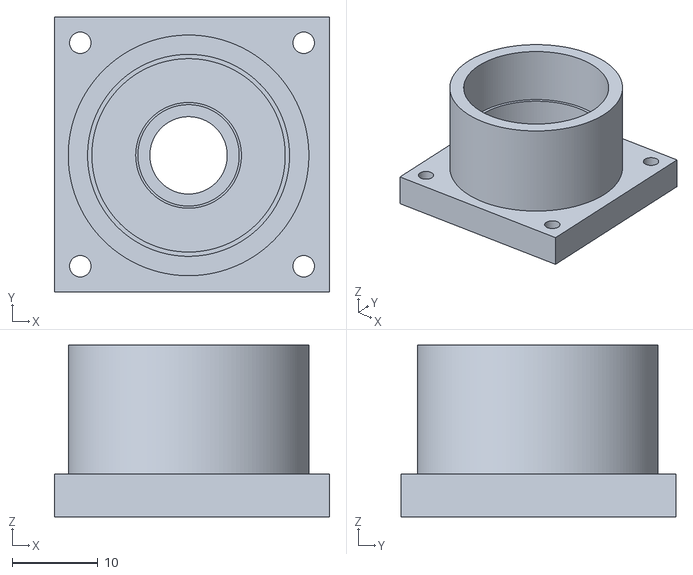
[picture p10: CAD file, 2026-10-11]
Boxes/TSL2591_Enclosure_H11.stl
32.0 x 32.0 x 20.0
