Juani005999/ROMV2-SQMLite/Boxes/Tube28_Cover_TPU.stl

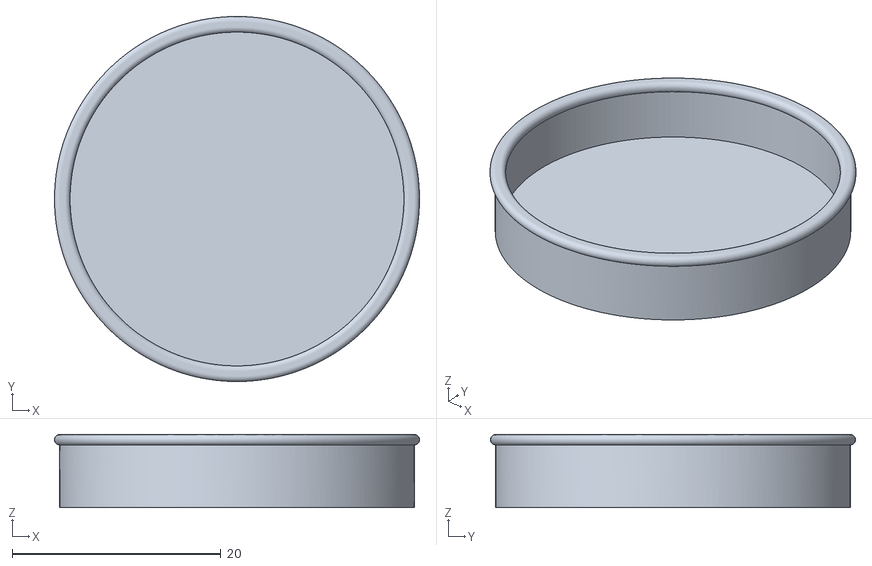
[picture p11: CAD file, 2026-10-11]
Boxes/Tube28_Cover_TPU.stl
35.0 x 35.0 x 7.00
