Juani005999/ROMV2-SQMLite/Boxes/ROMV2_TopLow.stl

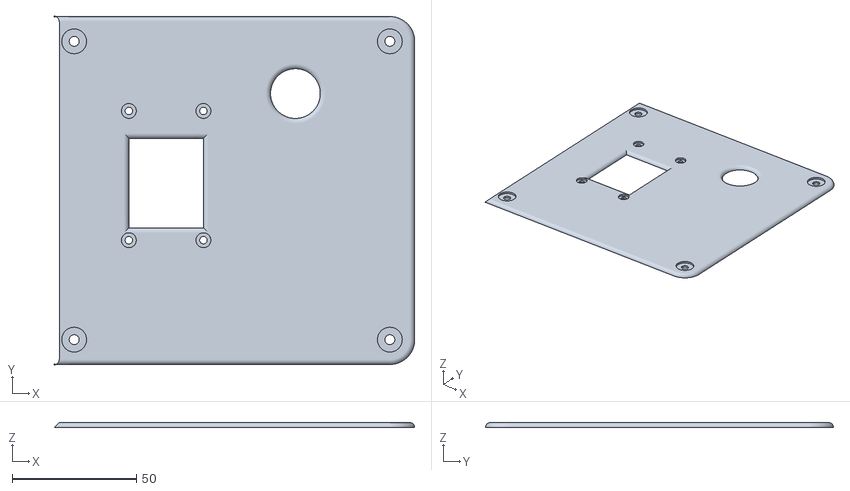
[picture p12: CAD file, 2026-10-11]
Boxes/ROMV2_TopLow.stl
145.0 x 140.0 x 2.00
