Juani005999/ROMV2-SQMLite/(list of files, cad)

Other CAD files:
Boxes/SQMLITE_Bottom_MicroUSB.stl
Boxes/ROM_V2_Publish.f3d
