Juani005999/ROMV2-SQMLite/(commit log)

2026-10-11 README : corrections, révision 2.1.0.1 et nom de l'installeur SQMLite
    - Correction des coquilles
    - Ajout de PubSubClient aux bibliothèques nécessaires
    - Noms des installeurs du driver ASCOM (ROMV2 / SQMLite)
    - Ajout de la révision 2.1.0.1 (Wifi / MQTT, Merge ROMV2 et SQMLite)
    - Renommage de l'installeur SQMLite : "Setup" avec majuscule
2026-10-11 Boxes : ajout des boîtiers SQMLite et mise à jour des STL ROMV2
    - Ajout des STL SQMLite (Bottom MicroUSB / USB-C, TopHigh, TopLow)
    - Pièces communes renommées sans préfixe ROMV2 (TSL2591_Enclosure, Tube15/Tube28_Cover_TPU)
    - Ajout de TSL2591_Enclosure_H11
    - Mise à jour de ROMV2_Bottom, ROMV2_Sensor et ROMV2_TopLow
    - Ajout du projet Fusion 360 ROM_V2_Publish.f3d
2026-10-11 README : noms SQMLite dans les sections Bluetooth et NINA
    - Driver ASCOM "SQMLite - Sky Quality Meter" dans la liste NINA
    - Périphérique BLE "SQM Lite" pour l'appairage
2026-10-11 README : nouvelle section Visualisation des données dans Grafana
    - Chaîne Mosquitto / Telegraf / InfluxDB 2.x / Grafana
    - Topics MQTT publiés par le ROMV2 et le SQMLite
    - Installation et configuration de chaque logiciel
    - Images MQTT_Pipeline et Grafana_Dashboard
2026-10-11 Sources et firmware : PubSubClient, depends et architectures esp32
    - Synchronisation des sources avec ROMV2_LIB (en-têtes des exemples et de ROMV2_APP_CONFIG.h)
    - Ajout de library.properties et LICENSE dans sources/ROMV2
    - Régénération de ROMV2_Firmware.zip
